epccs/RPUadpt/Hardware/README.md

# Hardware

## Overview

This shield board plugs into a control board (e.g. [RPUno], [Irrigate7], or [Punica]) to interface it with a multi-drop serial bus. 

[RPUno]: https://github.com/epccs/RPUno
[Irrigate7]: https://github.com/epccs/Irrigate7
[Punica]: https://github.com/epccs/Punica

## Inputs/Outputs/Functions

```
        Full Duplex serial RX and TX lines
        Half Duplex management line DTR
        RX, TX, and management lines connect to RS-485 tranceivers
        Differential pairs from transceivers allow multi-drop of the serial connections
        The transceivers receiver has Fail Safe so all see 0V as a HIGH.
        Power is taken from +5V of the control board.
        TWI0 (I2C) interface between local programable unit and manager.
        TWI1 (I2C) interface between local host and manager.
        IOFF buffers are used for UART and SPI host interface.
        IOFF allows the serial and control to remain functional when the host is powered down.
        UART and SPI interface buffers work with host voltage 5V to 1.8V.
```

## Uses

```
        Daisy chain serial from multiple control boards to a host.
        Use a point to point mode to bootload firmware to an addressed target.
        Use SPI to transfer data from a local host master to local programable unit slave.
        Or use the SPI local programable unit as master to operate a MicroSD card as slave.
```

## Notice

The serial port is a wired connection. The hardware is raw and lacks training wheels (i.e. it is not a polished product). The ATmega328pb toolchain is not widely available (e.g. {Debain: {stretch:no, buster:yes, sid:yes}} )

# Table Of Contents

1. [Status](#status)
2. [Design](#design)
3. [Bill of Materials](#bill-of-materials)
4. [How To Use](#how-to-use) 

# Status

Status RPUadpt Status

```
        ^6  Done: Design, Layout, BOM, Review*, Order Boards, Assembly, Testing, Evaluation.
            WIP: 
            Todo:  
            *during review the Design may change without changing the revision.
            add IOFF buffer between host (e.g. offboard FTDI Friend) and tranceiver like RPUpi has
            add IOFF buffer between optional host SPI and controler like RPUpi
            add chip sellect from the host to IO10 (which has nSS, it is missing on RPUpi)
            SPI pinout can match MicroSD card breakout (https://www.adafruit.com/product/254)
            add a jumper to power the SPI from the controller (e.g. RPUno +5V)
            remove ADC6 connction to voltage divider of +5V pin.

        ^5 Done: Design, Layout, BOM, Review*, Order Boards, Assembly, Testing, Evaluation.
           removed from tindie is used in some locations.
```

Debugging and fixing problems i.e. [Schooling](./Schooling/)

Setup and methods used for [Evaluation](./Evaluation/)

# Design

The board is 0.063 thick, FR4, two layer, 1 oz copper with ENIG (gold) finish.

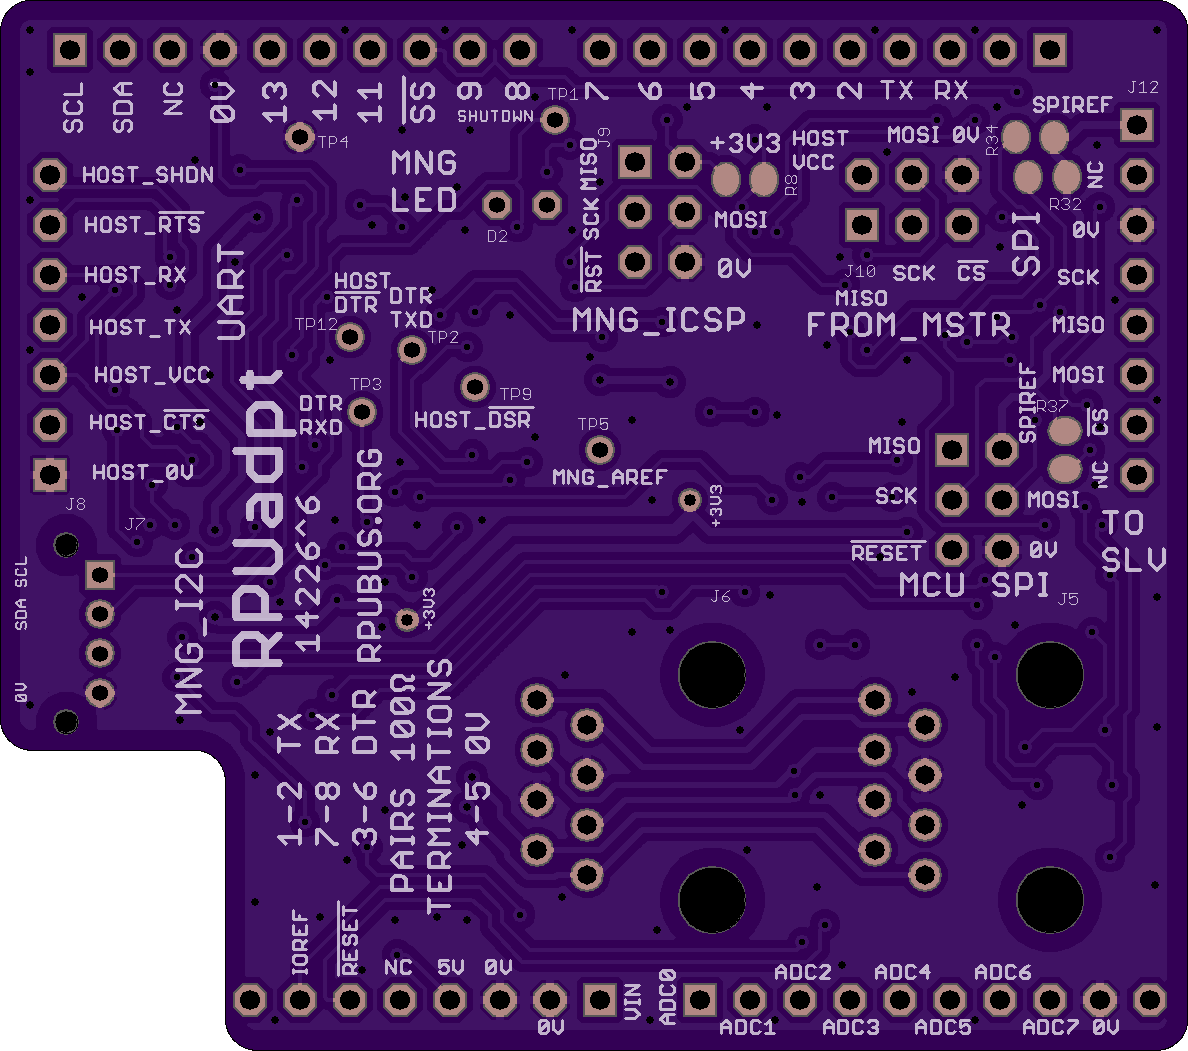
[picture p3: Hardware/Documents/14226,Top.png]
Top RPUadpt Top

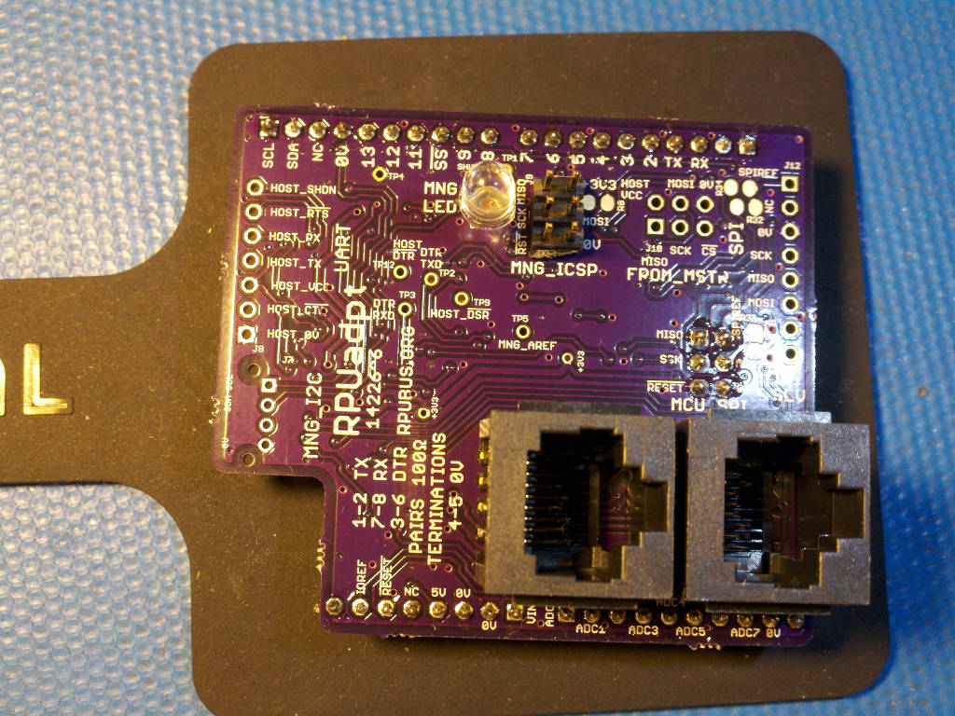
[picture p4: Hardware/Documents/14226,TAssy.jpg]
TAssy RPUadpt Top Assy

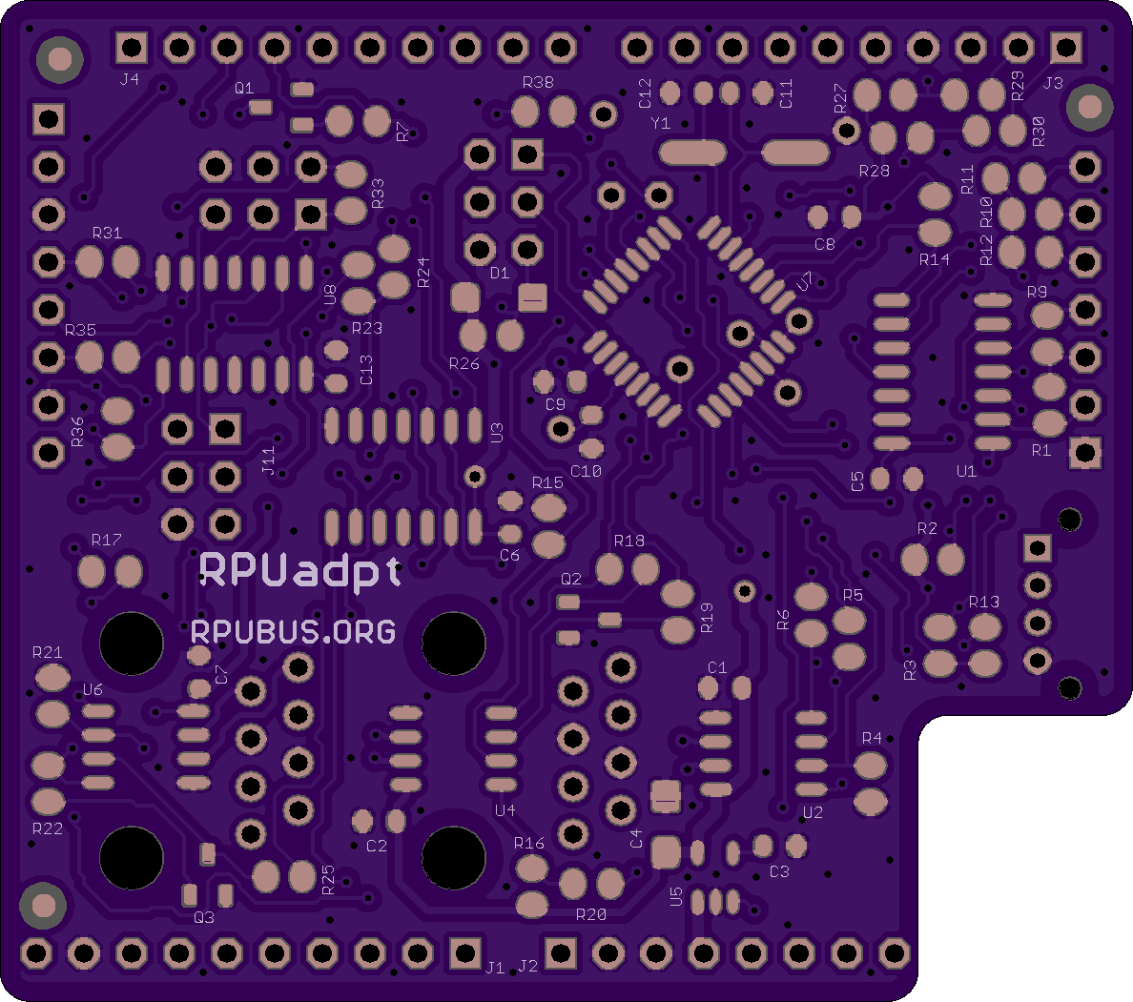
[picture p5: Hardware/Documents/14226,Bottom.png]
Bottom RPUadpt Bottom

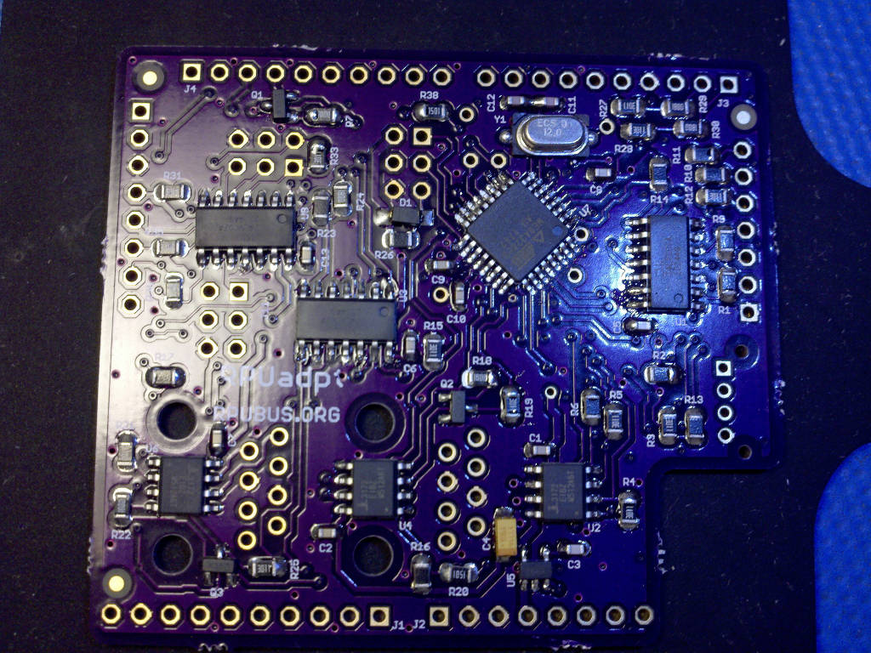
[picture p6: Hardware/Documents/14226,BAssy.jpg]
BAssy RPUadpt Bottom Assy


## Electrical Parameters (Typical)

```
        5V pin needs 150mA (RPUno has over 1A) to power RPU_BUS
        This is OSH so refer to the parts used for storage and operation limits.
```

## Electrical Schematic

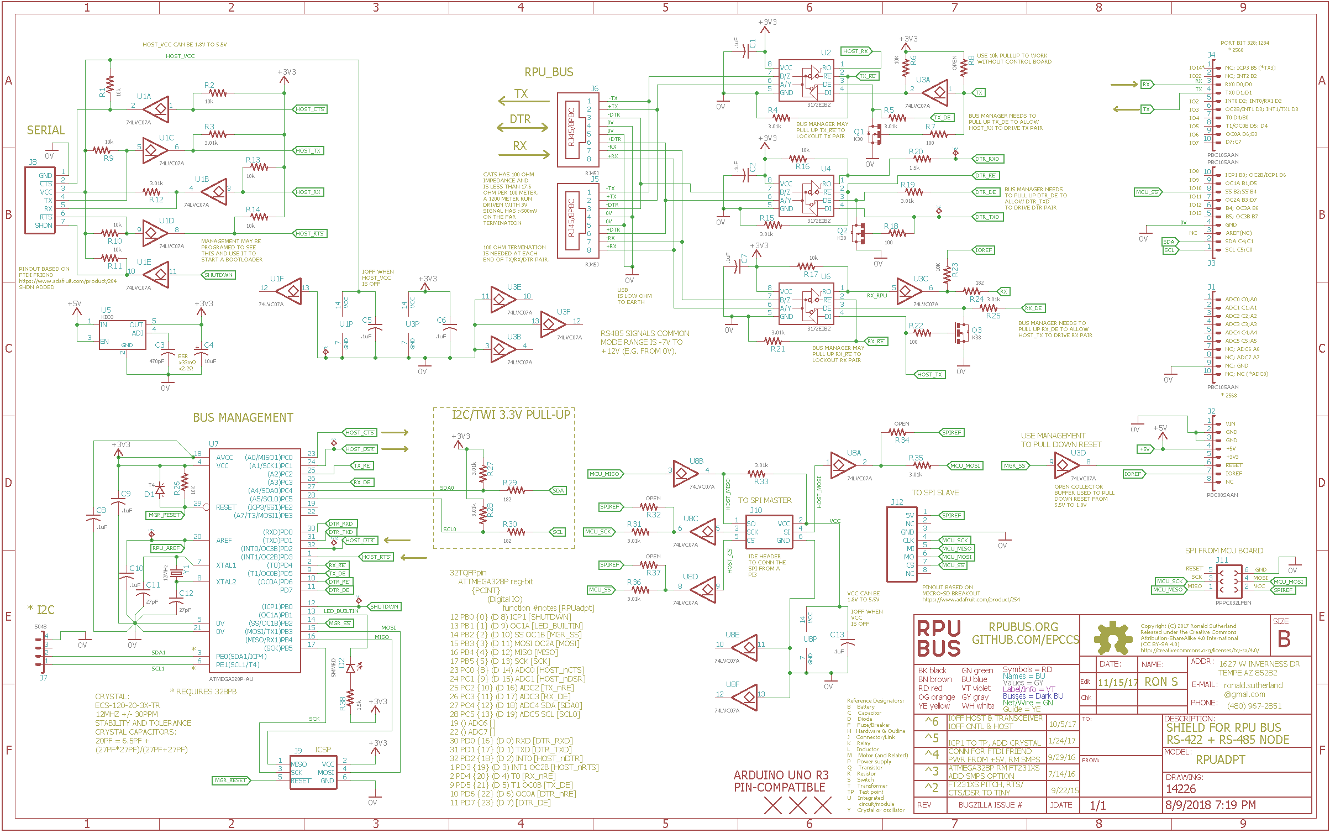
[picture p7: Hardware/Documents/14226,Schematic.png]
Schematic RPUadpt Schematic


## Testing

Check correct assembly and function with [Testing](./Testing/)

# Bill of Materials

The BOM is a CVS file, import it into a spreadsheet program like LibreOffice Calc (or Excel), or use a text editor.

Option | BOM's included
----- | ----- 
A. | [BRD] 
M. | [BRD] [SMD] [HDR] 
Y. | [BRD] [SMD] [HDR] [CAT5]

[BRD]: ./Design/14226BRD,BOM.csv
[SMD]: ./Design/14226SMD,BOM.csv
[HDR]: ./Design/14226HDR,BOM.csv
[CAT5]: ./Design/14226CAT,BOM.csv

# How To Use

## ICSP

[ArduinoISP] sketch is on an [Uno] and a level converter (e.g. [ICSP]) is between the boards. I then run the build rule (e.g. "make isp") to program the bus manager with the [Remote] firmware. With that, I can plug the RPUadpt into an RPUno and serial bootload the controller firmware (e.g. [Solenoid] with [K3]). An RPUftdi and Uno clone can be used with a host to communicate with the RPUadpt and its controller board. Additional boards will need the [Remote] firmware to have the bus address set in EEPROM.

[ArduinoISP]: https://github.com/arduino/Arduino/blob/master/build/shared/examples/11.ArduinoISP/ArduinoISP/ArduinoISP.ino
[Uno]: https://www.adafruit.com/product/50
[ICSP]: https://github.com/epccs/Driver/tree/master/ICSP
[Remote]: ../Remote
[Solenoid]: https://github.com/epccs/RPUno/tree/master/Solenoid
[K3]: https://github.com/epccs/Driver/tree/master/K3

__WARNING: The shield will be damaged if removed from a powered MCU board. Before separating the shield from the MCU board it is very important to check that all power sources are disconnected.__

The CAT5 needs wired just like an Ethernet cable following [T568A] (or T568B) method. 

[T568A]: https://en.wikipedia.org/wiki/Category_5_cable

Grounding should occur at one location only. If a RPUftdi is used then the host frame will be connected to the local earth grounding system through USB. Unfortunately, the ground wires within CAT5 will not survive a lightning strike and will bring it to the host. To reduce the risk run a #14 AWG ground wire between the remote device and the ground system connected to the host chassis. Also, the host chassis needs a good (#14 AWG or larger) wire to the same ground system (see NEC sec 250). 

The RX, TX, and DTR pair need a 100 Ohm termination on each end of the CAT5 daisy chain. I'm going to supply a RJ45 plug with terminations for now.

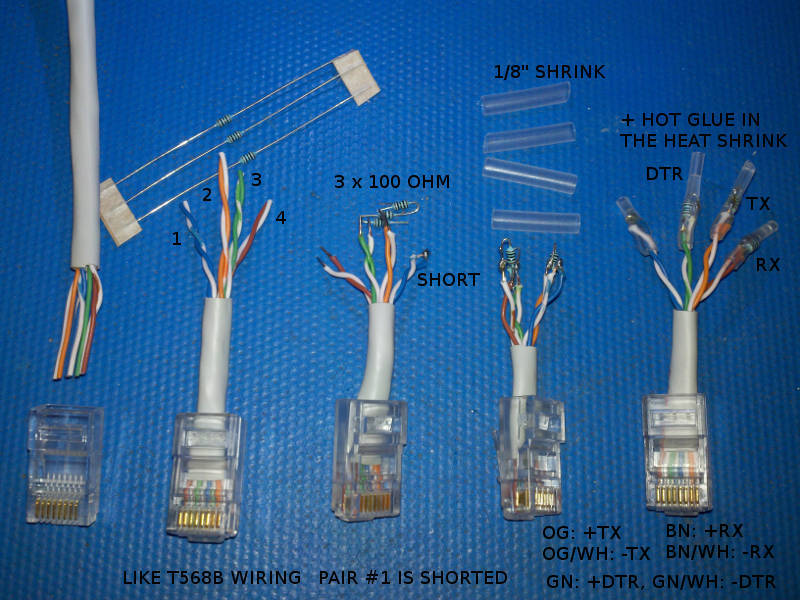
[picture p8: Hardware/Evaluation/14226^5_RPU_busTermination.jpg]
Bus Termination
