epccs/RPUadpt/Hardware/Design/14226BRD,BOM.csv

LINE | REF | QTY | EPCCS TYP | EPCCS PN | MFG@PN | DESCRIPTION | NOTES | COST EA | LINE COST | BIN
 |  |  |  |  |  | RPUadpt Board |  |  | TOTAL
 |  |  |  |  |  | 11/15/17 (14226^6) |  |  | =SUM(J7:J100)
1 |  | =1/3 | BOARD | OSHPARK |  | PCB 2 LAYER ENIG 3 COPY | () | 24.90 | =C5*I5 | ADPT
 |  |  |  |  |  | NOTES
