epccs/RPUadpt/(threads)

Thread 1 (2018-09-07):

A better way to deal with startup glitch on DTR pair

epccs, 2018-09-07:
To the UART init code add

```
UCSR0A = 0;
```

https://forum.arduino.cc/index.php?topic=567193.0
