epccs/RPUadpt/Hardware/Documents/14226,Schematic.pdf

# RPU_BUS

TX

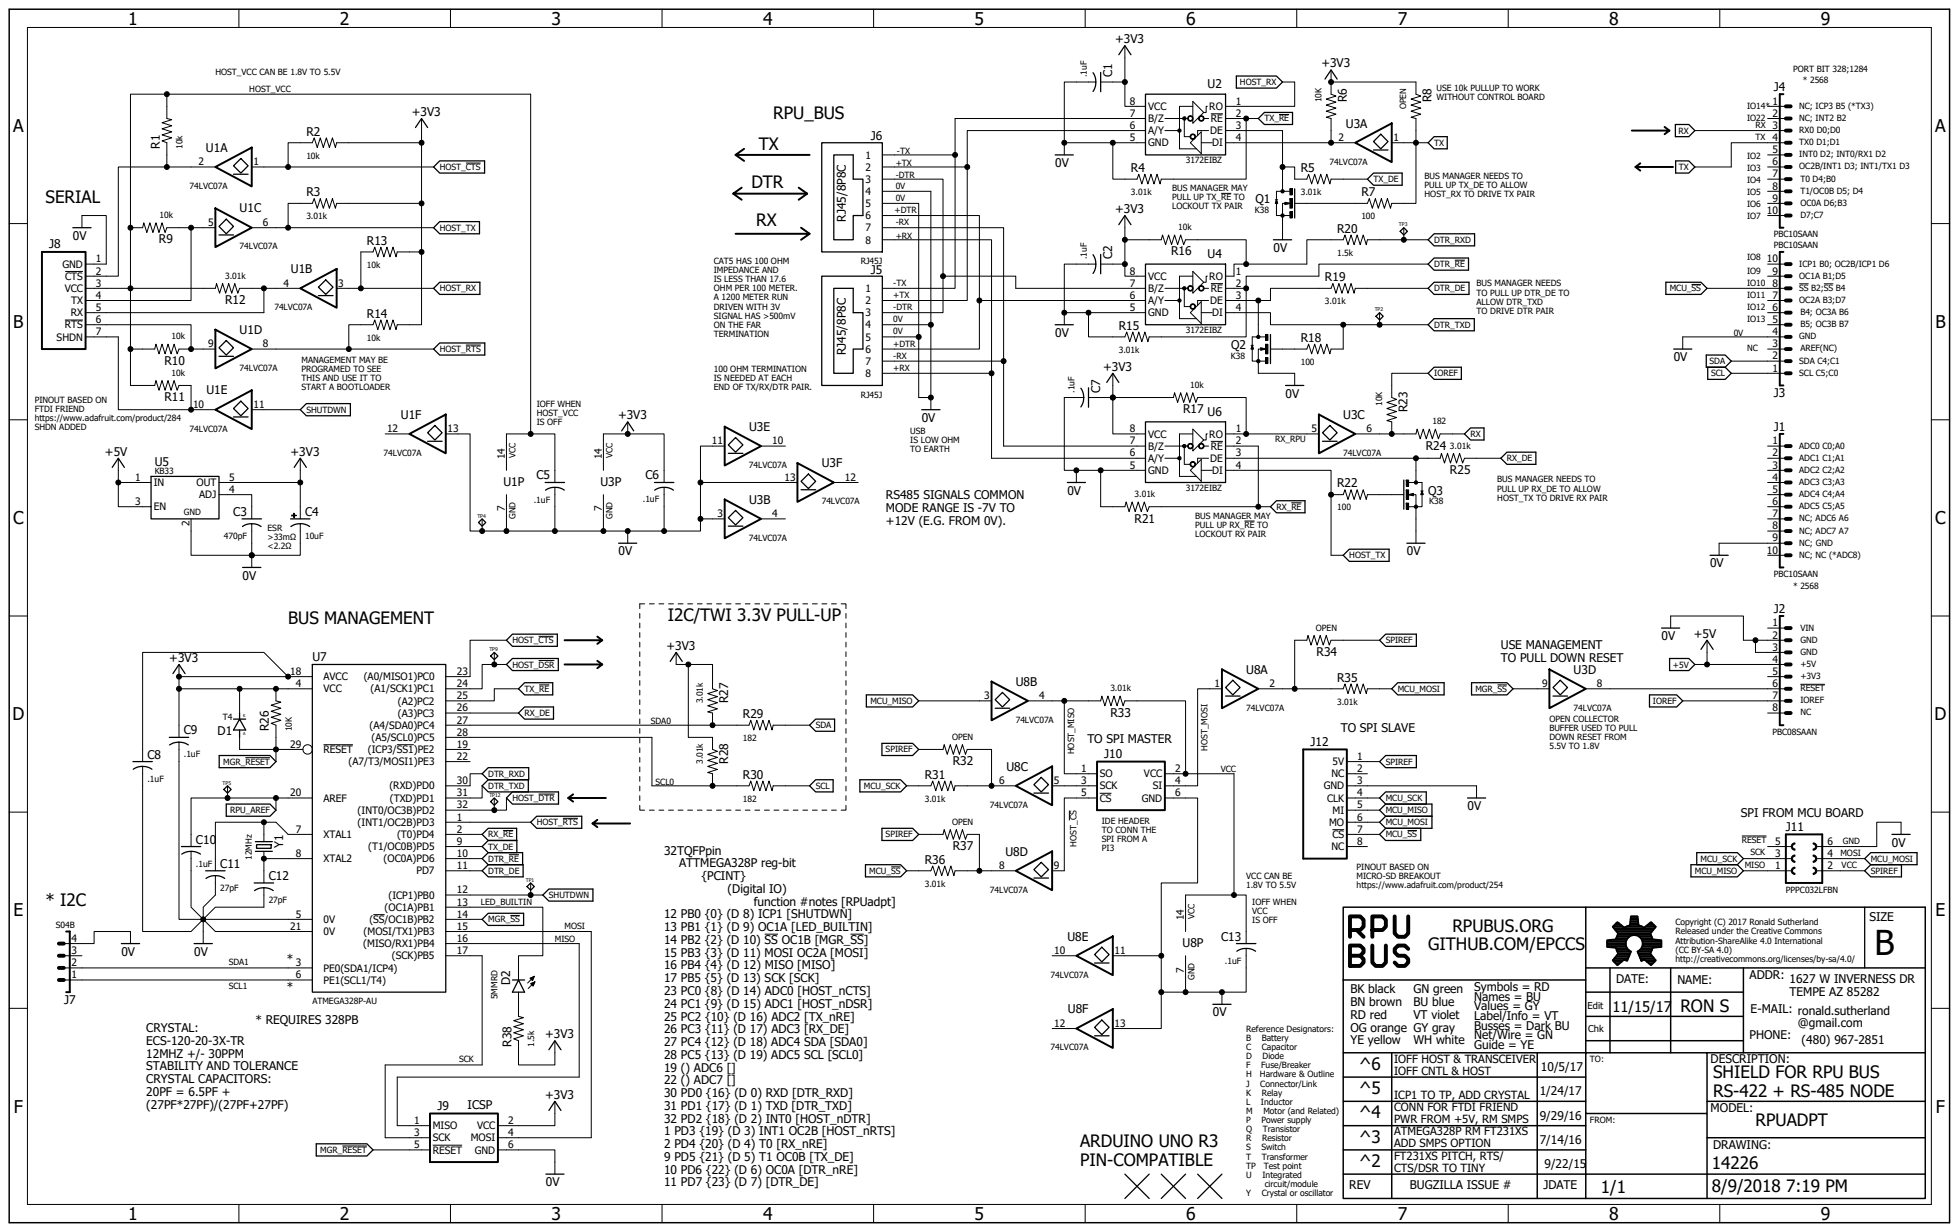
[picture p28: page 1]

USE 10k PULLUP TO WORK
WITHOUT CONTROL BOARD

BUS MANAGER NEEDS TO
PULL UP TX_DE TO ALLOW
HOST_RX TO DRIVE TX PAIR

BUS MANAGER NEEDS
TO PULL UP DTR_DE TO
ALLOW DTR_TXD
TO DRIVE DTR PAIR

MANAGEMENT MAY BE
PROGRAMED TO SEE
THIS AND USE IT TO
START A BOOTLOADER

100 OHM TERMINATION
IS NEEDED AT EACH
END OF TX/RX/DTR PAIR.

PINOUT BASED ON
FTDI FRIEND
https://www.adafruit.com/product/284
SHDN ADDED

PULL UP RX_DE TO ALLOW
HOST_TX TO DRIVE RX PAIR

RS485 SIGNALS COMMON
MODE RANGE IS -7V TO
+12V (E.G. FROM 0V).

USE MANAGEMENT
TO PULL DOWN RESET

74LVC07A
OPEN COLLECTOR
BUFFER USED TO PULL
DOWN RESET FROM

SPI FROM MCU BOARD

MICRO-SD BREAKOUT
https://www.adafruit.com/product/254

Copyright (C) 2017 Ronald Sutherland
Released under the Creative Commons
Attribution-ShareAlike 4.0 International
http://creativecommons.org/licenses/by-sa/4.0/

Edit | 11/15/17 RON S

Chk

^6 | IOFF HOST & TRANSCEIVER IOFF CNTL & HOST | 10/5/17 | TO: | DESCRIPTION: SHIELD FOR RPU BUS RS-422 + RS-485 NODE
^5 | ICP1 TO TP, ADD CRYSTAL | 1/24/17
^4 | CONN FOR FTDI FRIEND PWR FROM +5V, RM SMPS | 9/29/16 | | MODEL: RPUADPT

^2 | FT231XS PITCH, RTS/ CTS/DSR TO TINY | 9/22/15

REV | BUGZILLA ISSUE # | JDATE
