epccs/RPUadpt/Hardware/Documents/14226,bAssy.pdf

Q1

J4 | J3

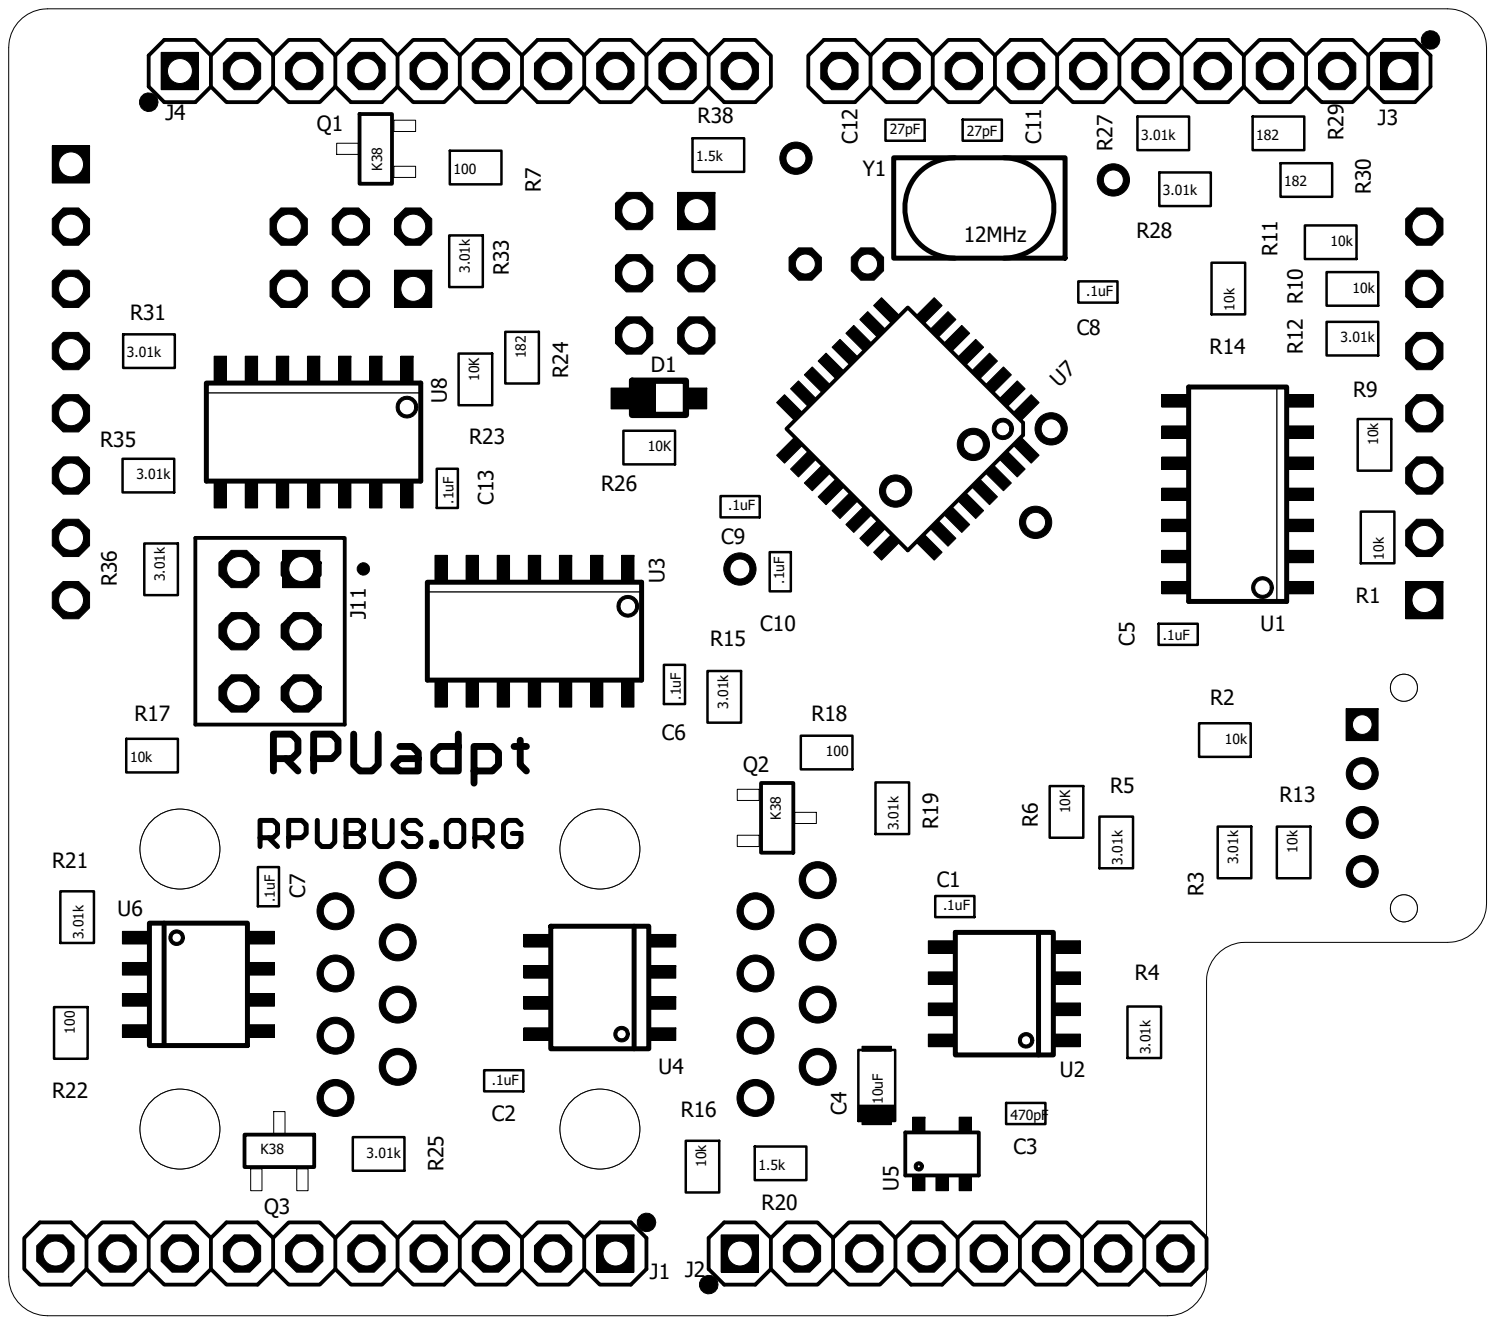
[picture p29: page 1]
