epccs/RPUadpt/Hardware/Documents/14226,tAssy.pdf

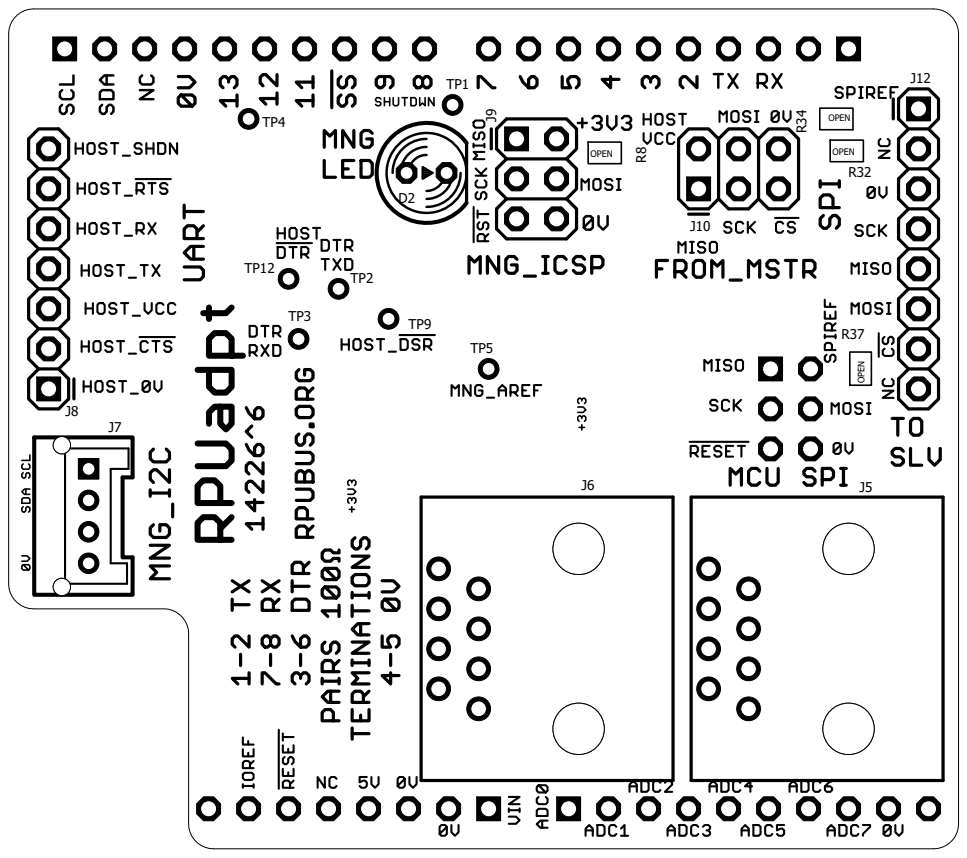
[picture p30: page 1]
