epccs/RPUadpt/Hardware/Design/MultiDrop.sch

## EAGLE design Hardware/Design/MultiDrop.sch (2018-06-28)

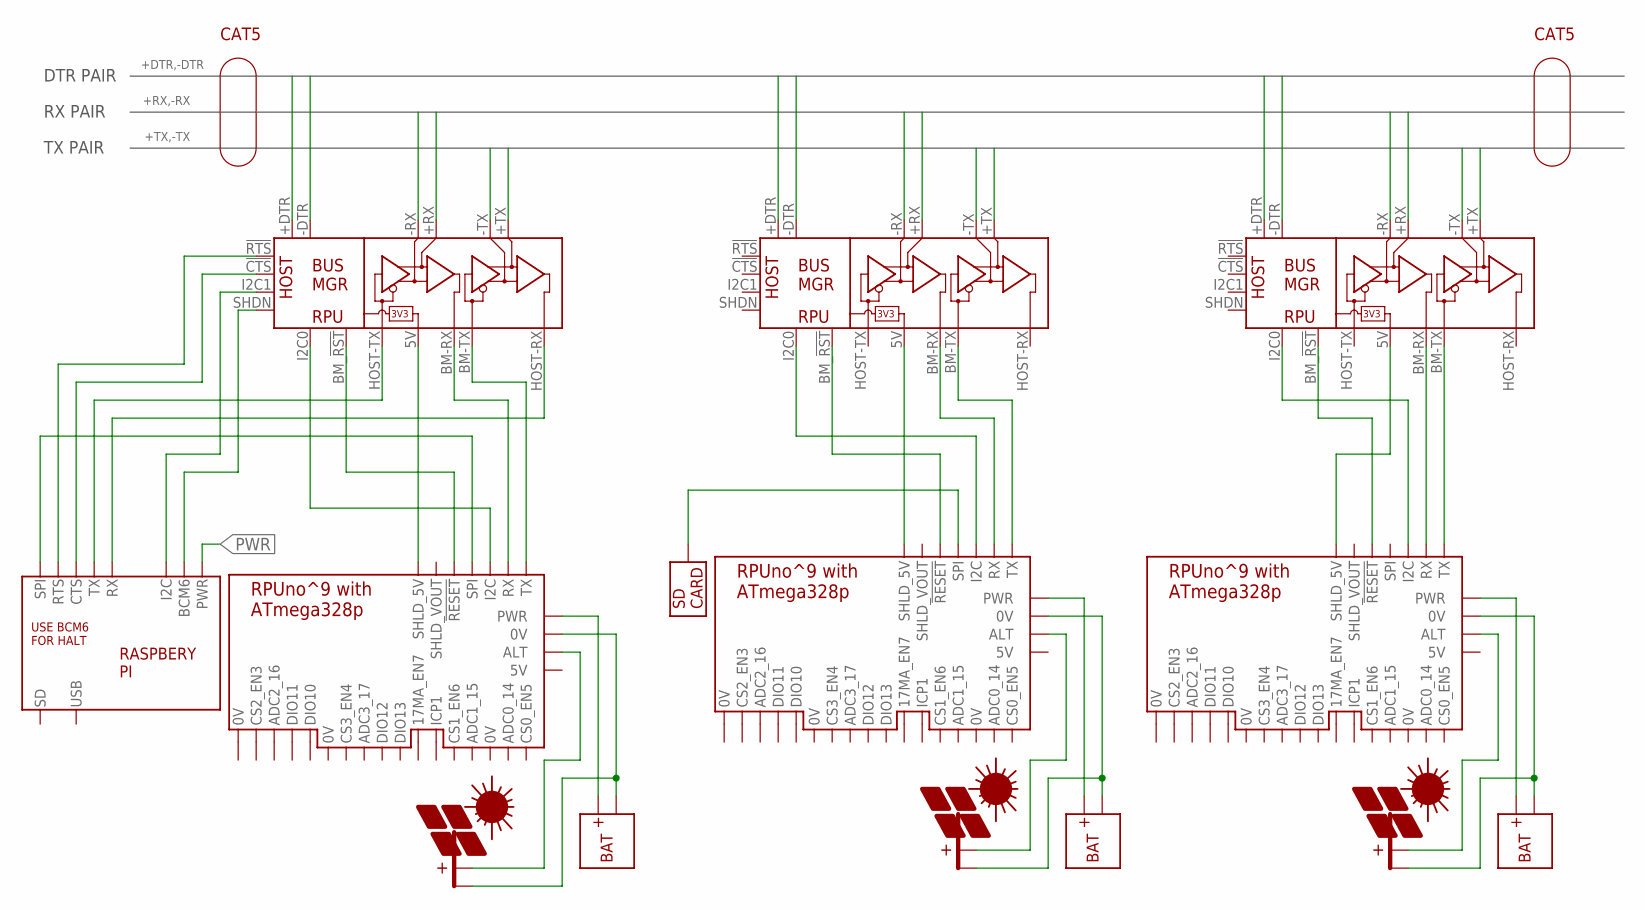
[picture p31: schematic MultiDrop.sch]

Parts:
BM1, BM2, BM3: RPUNO; NA-30
PV1, PV2, PV3: PV; NA-30
SD1: SD; NA-30
U$1, U$2, U$4: BUS_MGR; WITH_RPU_NAMES
U$3, U$5, U$9: BAT; NA-30
U$7: PI; NA-30

Connections:
+DTR: U$1.+DTR
+DTR1: U$2.+DTR
+DTR3: U$4.+DTR
+RX: U$1.+RX
+RX1: U$2.+RX
+RX3: U$4.+RX
+TX: U$1.+TX
+TX1: U$2.+TX
+TX3: U$4.+TX
-DTR: U$1.-DTR
-DTR1: U$2.-DTR
-DTR3: U$4.-DTR
-RX: U$1.-RX
-RX1: U$2.-RX
-RX3: U$4.-RX
-TX: U$1.-TX
-TX1: U$2.-TX
-TX3: U$4.-TX
unnamed: BM2.1 (TX), U$1.BM-TX (BM_TX)
unnamed: BM2.2 (RX), U$1.BM-RX (BM_RX)
unnamed: BM2.4 (SPI), U$7.10 (SPI)
unnamed: U$1.!CTS, U$7.1 (CTS)
unnamed: U$1.!RTS, U$7.2 (RTS)
unnamed: U$1.SHDN, U$7.7 (BCM6)
unnamed: U$1.I2C1, U$7.8 (I2C)
unnamed: U$1.HOST-RX (HOST_RX), U$7.3 (RX)
unnamed: U$1.HOST-TX (HOST_TX), U$7.4 (TX)
unnamed: BM1.1 (TX), U$2.BM-TX (BM_TX)
unnamed: BM1.2 (RX), U$2.BM-RX (BM_RX)
unnamed: BM2.8 (PWR), U$9.1 (+BAT)
unnamed: BM3.6 (SHLD_5V), U$4.5V (PWR)
unnamed: BM3.1 (TX), U$4.BM-TX (BM_TX)
unnamed: BM2.9 (0V), PV2.2 (-PV), U$9.2 (-BAT)
unnamed: BM1.20 (ALT), PV1.1 (+PV)
unnamed: BM2.20 (ALT), PV2.1 (+PV)
unnamed: BM1.4 (SPI), SD1.1
unnamed: BM1.9 (0V), PV1.2 (-PV), U$3.2 (-BAT)
unnamed: BM3.2 (RX), U$4.BM-RX (BM_RX)
unnamed: BM1.8 (PWR), U$3.1 (+BAT)
unnamed: BM3.20 (ALT), PV3.1 (+PV)
unnamed: BM3.9 (0V), PV3.2 (-PV), U$5.2 (-BAT)
unnamed: BM3.8 (PWR), U$5.1 (+BAT)
unnamed: BM2.6 (SHLD_5V), U$1.5V (PWR)
unnamed: BM2.5 (!RESET), U$1.BM_!RST! (BM-!RST!)
unnamed: BM3.3 (I2C), U$4.I2C0
unnamed: BM2.3 (I2C), U$1.I2C0
unnamed: BM3.5 (!RESET), U$4.BM_!RST! (BM-!RST!)
unnamed: BM1.5 (!RESET), U$2.BM_!RST! (BM-!RST!)
unnamed: BM1.6 (SHLD_5V), U$2.5V (PWR)
unnamed: BM1.3 (I2C), U$2.I2C0
PWR: U$7.12 (PWR)

Notes on the sheet:
CAT5
DTR PAIR
RX PAIR
TX PAIR
