epccs/RPUadpt/(commit log)

2015-09-29 fuse settings
2015-09-29 LED not fully off due to 5V, fix by cycling between input and output
2015-11-16 Blink for arduino
2015-12-06 testing flow control lines
    ATtiny1634's PA3 has an issue as input
2015-12-06 ArduinoISP sketch is from Arduino IDE 1.6.6
2016-08-21 BlinkLED: for ^3
    switching to Makefiles
2016-09-10 Remote: sorting out issues
    a lot like Remote2Host on RPUftdi
    [main.c]
2016-09-11 Remote: updates from Mercurial repo
    lockout everything if host is foreign but only mcu if host is local
    disconnect when DTR pair has byte > 0x7F, start idea of a bus error
    char is like an int8_t on AVR but I thunked with uint8_t
    need improved host_is_foreign logic
    [main.c]
2016-11-05 CheckDTR: ^4 board tested
2016-11-16 Hardware: add schematic
2016-11-16 Hardware: add board
    [14226,BOM.csv, 14226.brd, 14226.sch]
2017-01-02 Remote: broadcast after I2C read of rpu_addr /w bootloader_started
2017-01-03 Hardware: reorg, add schooling
    [14226,BOM.csv, 14226.brd, 14226.sch, MultiDrop.sch]
2017-01-15 Hardware: ^5 review
    [14226.brd, 14226.sch]
2017-01-25 Hardware: ^5 more review
    [14226,BOM.csv, 14226.brd, 14226.sch, MultiDrop.sch]
2017-01-26 Hardware: example
    [MultiDrop.sch]
2017-03-21 Hardware: ^5 evaluation south wall enclosure
    [14226,BOM.csv]
2017-04-01 Hardware: through hole parts used for bus termination
    [14226,BOM.csv]
2017-05-22 RPUadpt: crystal capacitors, eagle is not for open hardware
    [14226,BOM.csv, 14226.brd, 14226.sch]
2017-05-25 Remote: add lockout to status and rename rxBuffer as i2cBuffer
2017-11-17 Hardware: ^6 changes lots, but the RS-422 as a remote should not have changed
    [14226,BOM.csv, 14226BRD,BOM.csv, 14226CAT,BOM.csv, 14226HDR,BOM.csv, 14226SMD,BOM.csv, MultiDrop.sch]
2018-06-25 BlinkLED: raspberry pi smbus toggles blink
2018-06-25 Hardware: eval i2c1 with i2c-debug
2018-06-26 Hardware: eval i2c1 with smbus from raspberry pi
2018-06-28 Remote: add twi1 /w commands 0, 2, 3, 6, 7 for host use
    [MultiDrop.sch]
2018-07-01 Hardware: ^6 eval spi
2018-07-10 core: add missing wiring pin numbers
2018-07-18 Hardware: bom, evaluation
    [14226SMD,BOM.csv]
2018-07-25 Hardware: ^6 evaluation with usb-uart
2018-08-10 Hardware: schematic notes
