epccs/RPUadpt/(notices)

Notices in the files:
CheckDTR/main.c:
This Library is free software: you can redistribute it and/or modify
it under the terms of the GNU General Public License as published by
the Free Software Foundation, either version 3 of the License, or
(at your option) any later version.
Remote/main.c:
modify it under the terms of the GNU General Public License
parts and their libraries:
Documentation: Copyright (C) 2014 Ronald Steven Sutherland
Attribution Share-Alike 3.0 License
http://creativecommons.org/licenses/by-sa/3.0
